ut-robotics/picr22-team-snax/electronics/mainboard_back_side.png

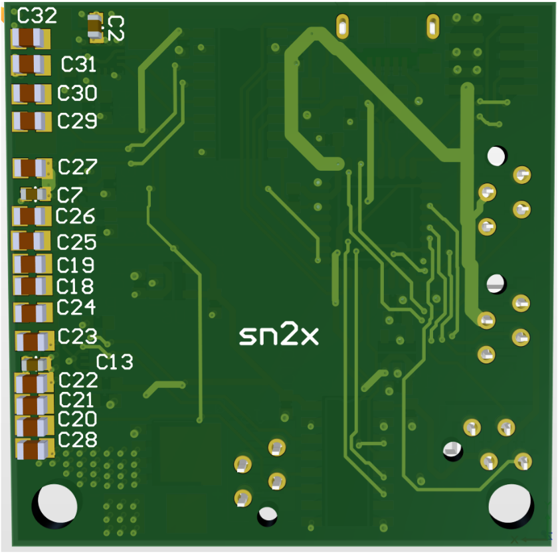
electronics/mainboard_back_side.png
