ut-robotics/picr22-team-snax/electronics/mainboard_front_side.png

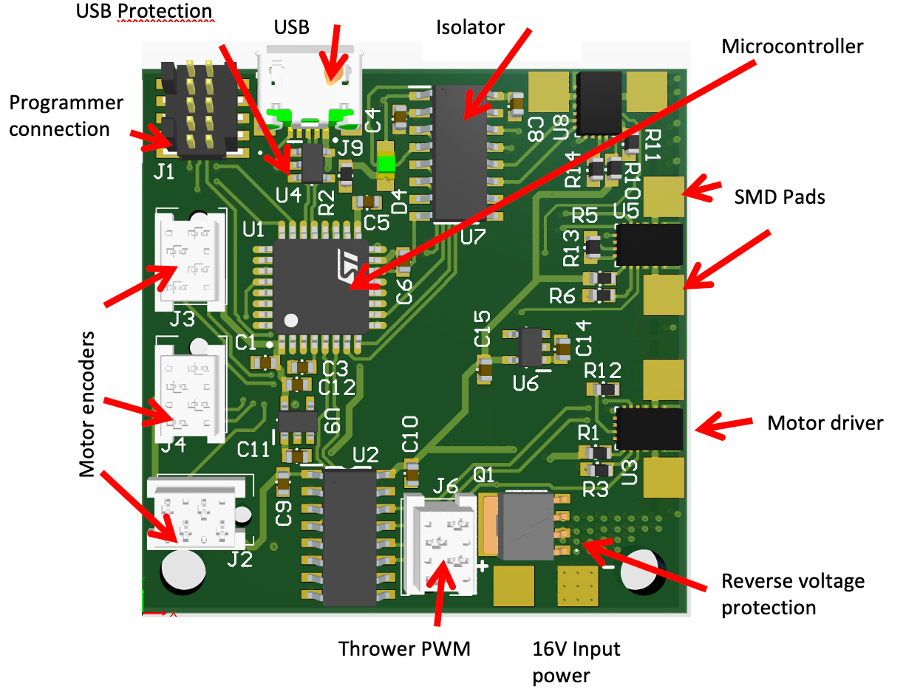
electronics/mainboard_front_side.png
