ut-robotics/picr22-team-snax/electronics/Mainboard schematics.pdf

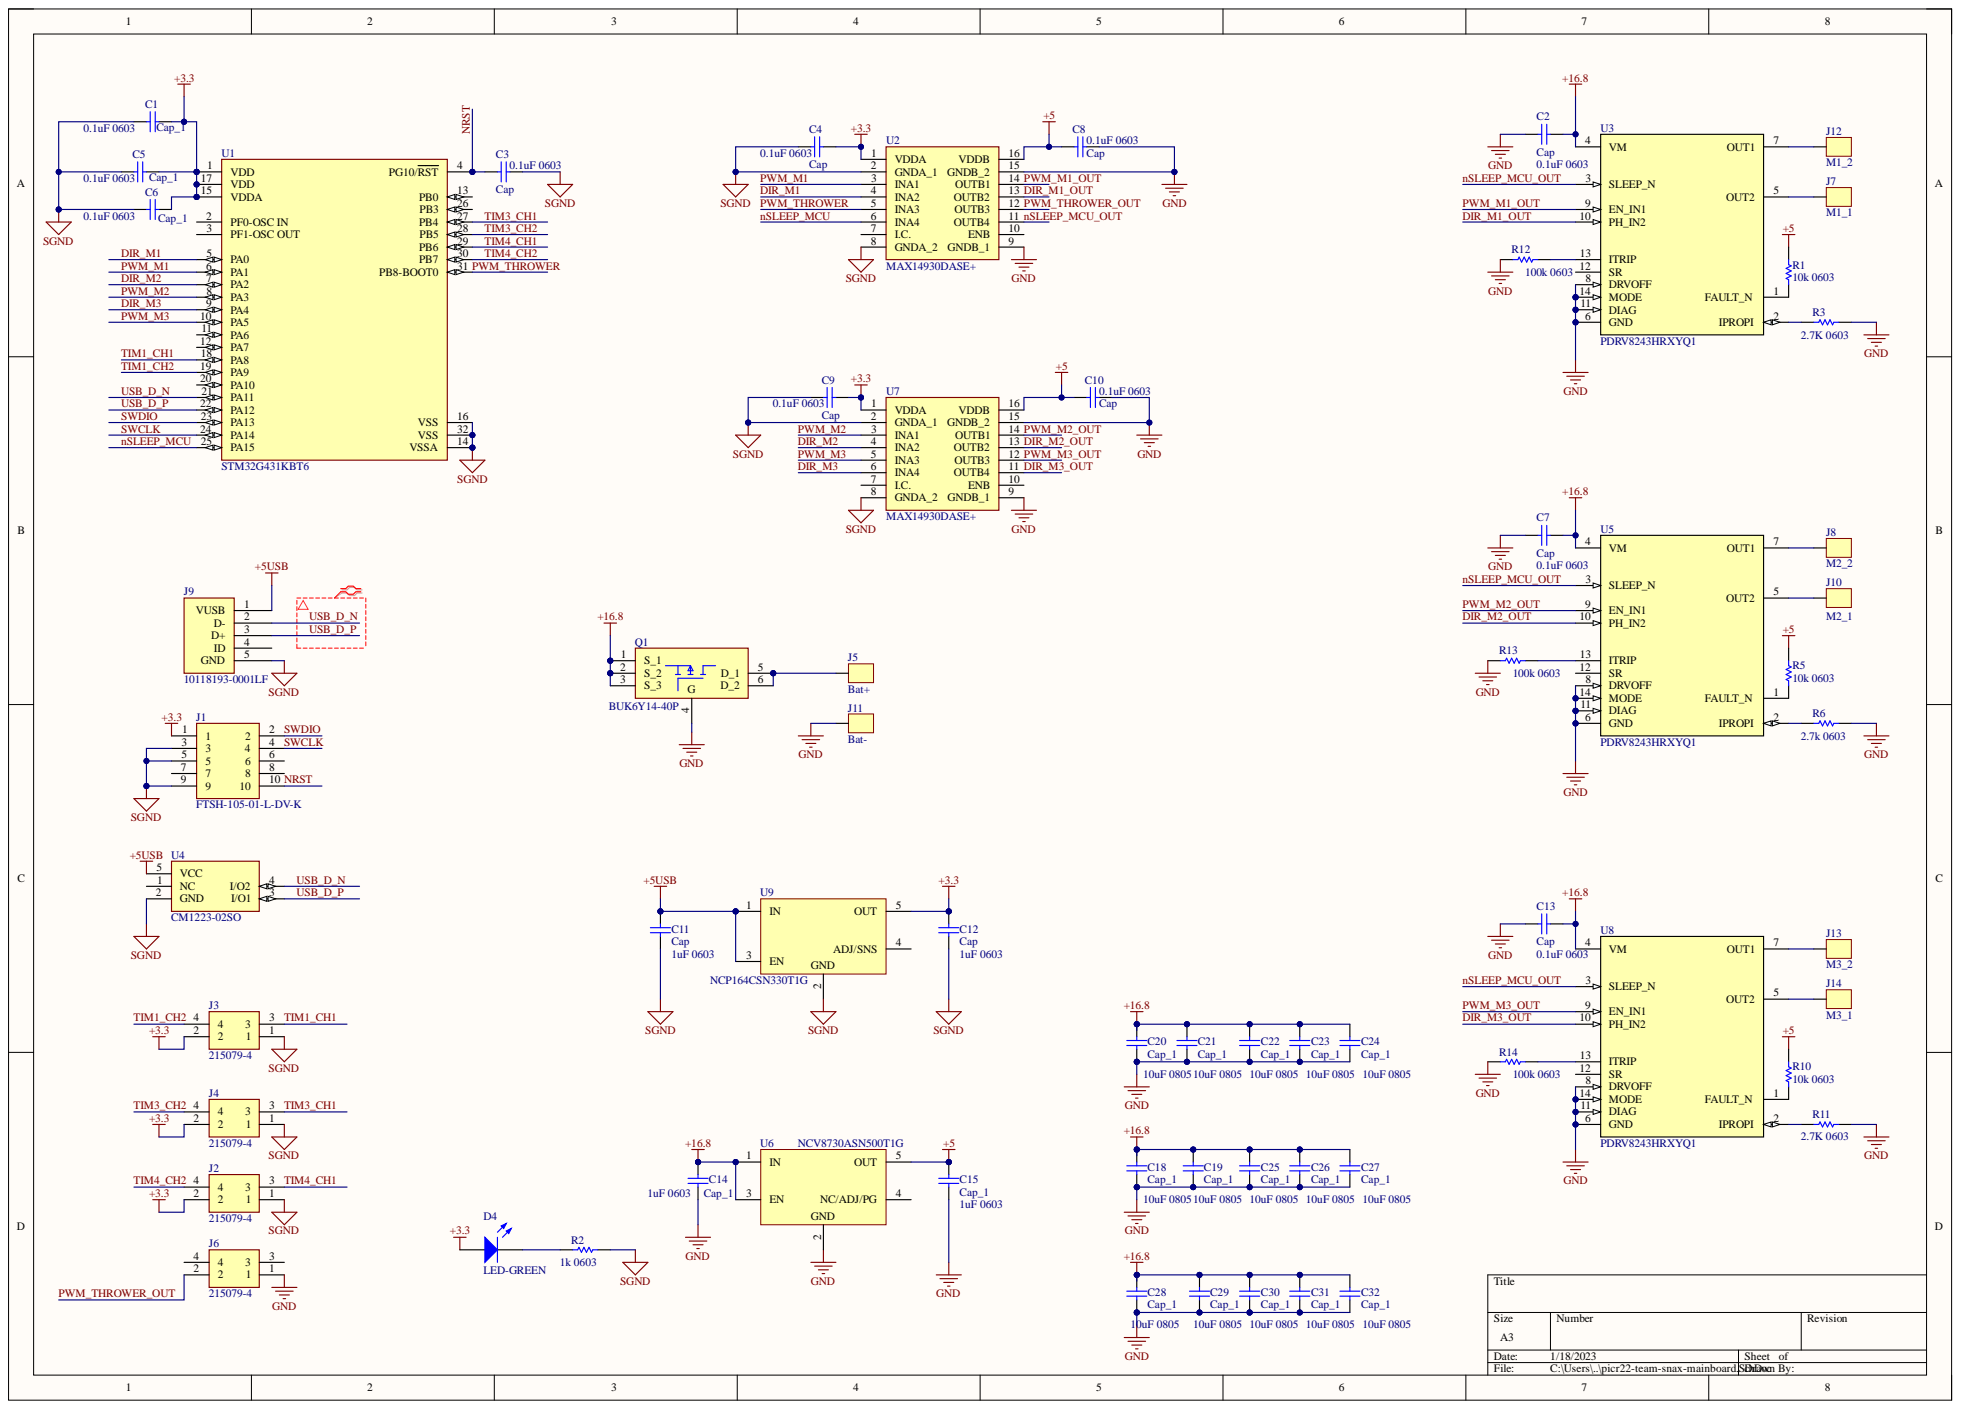
[picture p5: page 1]
