ut-robotics/picr22-team-snax/(list of files, drawings)

Other design files:
electronics/corrcted footprint.PcbLib
electronics/MotorDriver/MotorDriver/MotorDriver.SCHLIB
electronics/NCV8730ASN500T1G.SchLib
electronics/picr22-team-snax-mainboard.PrjPcb
electronics/picr22-team-snax-mainboard.SchDoc
electronics/SOIC-16N.PcbLib
electronics/team-snax-mainboard.PcbDoc
