ut-robotics/picr22-team-snax/(threads)

Thread 1 (2022-10-01):

[Mechanics] dogbones missing

Akustav, 2022-10-01:
You should add dog bones to attach tabs components in a flush manner.

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

Closed 2022-10-09.

Thread 3 (2022-10-01):

[Mechanics] Assembly warnings

Akustav, 2022-10-01:
Currently there are warnings in the assembly file. These should be fixed:
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

Closed 2022-10-27.

Thread 4 (2022-10-01):

[Mechanics] underdefined sketches

Akustav, 2022-10-01:
There are currently under-defined sketches:
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

This can lead to unpredictable changes in model features when another sketch is changed. You should add dimensions until sketches turn black.

ToxaRyd, 2022-10-04:
Did my best but errors of over constrain occur...

Akustav, 2022-10-09:
Hm, currently seems fine to me. Overall when it gives you over-defined warnings, it means that you added multiple different dimensions to the same area. Usually the simplest way to see what is undefined is to take the sketch and try dragging some blue lines around. This shows you what elements start moving.

Closed 2022-10-09.

Thread 5 (2022-10-01):

[Mechanics] Thrower width might be too small

Akustav, 2022-10-01:
Squash balls can be over 40mm in width. Exactly 40 mm might be too tight for balls. This can create issues in getting a ball into the thrower and the ball can rub against the sidewalls when being thrown, reducing throw speeds.

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

Closed 2022-10-09.

Thread 6 (2022-10-01):

[Mechanics] Thrower and ramp are not centered

Akustav, 2022-10-01:
Is this intended, that the thrower and internal ramp don't have the same center point? The further the ball travels in the thrower, the less it is accelerated by the motor.

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

ToxaRyd, 2022-10-04:
Yep, I was suggested that the first contact with the ball should have the motor, and only after the ramps

Akustav, 2022-10-09:
Hm okay... I would suggest to reduce the delta a little, currently it is around 9.5mm:

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

You might remove acceleration potential by reducing contact pressure so fast.

ToxaRyd, 2022-10-14:
Have decreased this distance by 3mm if I am not mistaken....resolved

Closed 2022-10-27.

Thread 7 (2022-10-09):

[Mechanics] Interference in thrower-chassis assembly

Akustav, 2022-10-09:
There is clipping here:

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

Is this intentional or a fault?

ToxaRyd, 2022-10-13:
yeah, thats was because model of that robots and its actual sizes are not the same. I took those from the real one, will try to fix that

ToxaRyd, 2022-10-14:
resolved but there are distance mistakes in the assembly of the robot itself, can show those somehow on practice session

Closed 2022-10-27.

Thread 8 (2022-10-09):

[Mechanics] Thrower motor not attached

Akustav, 2022-10-09:
It is useful to have the motor also attached to the thrower with the cable lead marked. This allows you to see that there is a path for the cables to exit.

ToxaRyd, 2022-10-14:
resolved

Closed 2022-10-27.

Thread 9 (2022-10-09):

[Mechanics] IMPORTANT!!! Edit files in the project instead of uploading

Akustav, 2022-10-09:
Currently you upload f3z files to the project. I think you upload them over the browser as well. This makes it hard to review the project, since I need to download the file and upload it back through fusion 360 to access the models.

You should use the picr22-team-snax project in the PICR team to create and edit files.

ToxaRyd, 2022-10-13:
Resolved!

Closed 2022-10-27.

Thread 10 (2022-11-09):

MCU pin assignment

ReikoR, 2022-11-09:
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

USB and programmer pins must be connected to pins PA11 to PA14:
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

Timer 1, 2 and 3 channels can't be connected to pins PA10 to PA15 like this:
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

Try to use STM32CubeIDE for creating the pin assignment.

Some more information on how to configure timers in STM32CubeIDE is on the firmware page:
https://ut-robotics.github.io/picr22-home/basketball_robot_guide/electronics/firmware.html

Please ask if it's not clear how to do the timer configuration and pin assignment.

ReikoR, 2022-11-22:
New pin assignment should work, but signals connected to `PB4`, `PB5`, `PB6`, `PB7` are incorrectly named.

On schematic:
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

In STM32CubeIDE:
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

Closed 2022-11-29.

Thread 12 (2022-11-09):

Incorrect net labels

ReikoR, 2022-11-09:
1. USB_D_M, USB_D_P
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

3. PWM_THROWER
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

4. PWM_THROWER_OUT
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

5. NRST missing
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

6. PWM_M3_OUT
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

Problems like this can be found with **Project -> Validate PCB Project**:
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

Closed 2022-11-22.

Thread 13 (2022-11-11):

Incorrect USB connenctor pinout

ReikoR, 2022-11-11:
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

Correct pinout:
1. VCC
2. D-
3. D+
4. ID
5. GND

https://pinoutguide.com/PortableDevices/micro_usb_pinout.shtml

Closed 2022-11-22.

Thread 14 (2022-11-11):

Don't use metric grid on the schematic

ReikoR, 2022-11-11:
Industry standard unfortunately is 100 mil grid. All the symbols are designed for it. Using different grid can cause issues with things not aligning with each other.

On the PCB it's better to use metric grid.

ReikoR, 2022-11-22:
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

There are a lot of "Off grid" warnings:
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

Use 100 mil grid and place all schematic object to that grid.

You can set grid to 100 mil (toggle grid with G), select objects on the schematic, use Edit -> Align -> Align To Grid (Shift + Ctrl + D) and adjust manually as necessary.

If symbols were not created with 100 mil grid, then the symbols also need to be changed.

ReikoR, 2022-11-29:
Move schematic objects to 100 mil grid.

One part of the schematic with misalignement:
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

markus-marandi, 2022-12-02:
done

ReikoR, 2022-12-03:
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

markus-marandi, 2022-12-03:
fixed

ReikoR, 2022-12-04:
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

markus-marandi, 2022-12-04:
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

markus-marandi, 2022-12-05:
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

Closed 2022-12-05.

Thread 15 (2022-11-11):

Use different ground nets to isolate MCU and motor drivers sides

ReikoR, 2022-11-11:
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

All MCU side components and all motor drivers side components should be connected to separate grounds. MCU side of the isolators should be connected to MCU ground and motor driver side to motor drivers ground.

Closed 2022-11-22.

Thread 19 (2022-11-11):

Incorrect DRV8243 pinout

ReikoR, 2022-11-11:
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

I guess that the footprint uses multiple pads per actual physical pad. I can't check since the library is not in the repository, but if it is, then it's a bad way to do it, since actual component has less pins:
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

Altium Designer allows the create custom pad shapes:
https://www.altium.com/documentation/altium-designer/working-with-custom-pad-shapes

Closed 2022-11-22.

Thread 20 (2022-11-11):

DRV8243 slew rate configuration

ReikoR, 2022-11-11:
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

Connecting 100k resistor to SR pin sets the slew rate to the highest value:
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

This can't be read form the datasheet, but highest slew rate caused problems last year with motors not starting or rotating properly. Using slew rates of 23 or 28 V/usec worked fine.

Closed 2022-11-22.

Thread 21 (2022-11-11):

DRV8243 current limiting

ReikoR, 2022-11-11:
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

From [datasheet](https://ut-robotics.github.io/picr22-home/basketball_robot_guide/electronics/drv8243-q1_datasheet_2021-08.pdf):
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

A resistor needs to be connected to IPROPI pin to limit the output current.

Current limit should be set to around 2-3A to help prevent motor from overheating. IPROPI resistor value should be calculated based on that.

Closed 2022-11-22.

Thread 24 (2022-11-11):

Bulk capacitors in too small package

ReikoR, 2022-11-11:
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

0603 is too small package for 10uF and especially 220uF 25V+ capacitors.

10uF would be fine in 0805 package.

220uF ceramic capacitor probably does not exist in any reasonable size.

I recommend about 5x 10 uF 0805 capacitors for each motor driver.

Closed 2022-11-30.

Thread 25 (2022-11-13):

[Mechanics] how easy was it to assemble?

Akustav, 2022-11-13:
Overall it seems file but I would have suggested an hourglass shape here for simpler assembly:

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

ToxaRyd, 2022-11-13:
Well, the force needed, though not difficult, may be problems with disassembling but still I a small problem to get rid of extra assembling operation and production of pcb plate to hold the bearings...

Closed 2022-11-13.

Thread 29 (2022-11-22):

3.3V regulator missing

ReikoR, 2022-11-22:
There is no regulator creating the 3.3V from USB 5V.

We have NCP164CSN330T1G regulator in the lab for that.

https://ut-robotics.github.io/picr22-home/basketball_robot_guide/electronics/components.html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

Closed 2022-11-29.

Thread 30 (2022-11-22):

Use switching regulator instead of linear regulator for servo power

ReikoR, 2022-11-22:
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

Linear regulators are too inefficient for higher currents.

We have these components available in the lab:

- XTPS62933DRLR (TPS62933 buck converter)
- SRP6060FA-5R6M (Inductor 5.6uH 10A)

You can use TI WEBENCH to get recommended designs for TI components:
https://webench.ti.com/power-designer/switching-regulator

**Considering that there is not too much time left to complete the design, I would recommend not adding servo connection and continuing with a simpler design.**

markus-marandi, 2022-12-02:
removed servo NCV and 215079-4 components

ReikoR, 2022-12-03:
If you're not using servos, then remove switching regulator and use linear regulator (NCV8730).

Isolators don't need high current and layout of NCV8730 is much simpler.

markus-marandi, 2022-12-03:
added ncv8730

ReikoR, 2022-12-04:
There is no 3.3V regulator any more.
And switching regulator (TPS62933) is still there.

markus-marandi, 2022-12-04:
removed TPS62933 and added ncp164
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

markus-marandi, 2022-12-04:
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

ReikoR, 2022-12-05:
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

Add more input and output capacitance to NCP164.

From [NCP164 datasheet](https://www.onsemi.com/pdf/datasheet/ncp164-d.pdf):
> **Input Decoupling (C<sub>IN</sub>)**
> It is recommended to connect at least 1 uF ceramic X5R or X7R capacitor between IN and GND pin of the device.

> **Output Decoupling (C<sub>OUT</sub>)**
> The device is designed to be stable with standard ceramics capacitors with values of 1 uF or greater.

Closed 2022-12-05.

Thread 31 (2022-11-26):

Add a spacer to the front of the thrower

Akustav, 2022-11-26:
I suggest adding a 45 mm spacer to the front. This increases thrower rigidity but also protects the motor from crashes. Maybe the motor cable angel could also be changed a little so it does not point directly outwards

ToxaRyd, 2022-11-26:
Done)

Akustav, 2022-11-27:
With the current implementation I also suggest rotating the motor so the cable is not routed from the front of the robot. This can damage the cables when hitting something.

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

ToxaRyd, 2022-11-29:
done

Closed 2022-11-30.

Thread 33 (2022-11-26):

No holes for camera mount fixating

Akustav, 2022-11-26:
The bottom plate has no holes for the camera mount, currently.

ToxaRyd, 2022-11-27:
done

Akustav, 2022-11-27:
The side wall holes are drilled manually but would be good if they are also added.

ToxaRyd, 2022-11-29:
easy to do but afraid of problems when making machining model...

Closed 2022-11-30.

Thread 34 (2022-11-26):

More support for camera legs

Akustav, 2022-11-26:
I suggest a little more support for the camera legs since they can wobble about, when the robot is is motion. The slots do not help. Maybe add a plate to the middle of the legs?

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

ToxaRyd, 2022-11-26:
Yeah, I planned to add there a plane, I just have not finished yet)

Akustav, 2022-11-27:
I see something added. How do you plan to fasten it. Additionally how do you plan to manufacture it?

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

ToxaRyd, 2022-11-27:
3d printing, cause it is just rigid component, no fixing needed, maybe just position fix through the adjustment of the holes in the camera legs

Akustav, 2022-11-27:
Some force needs to hold it in place, no? If it is just rattling there, there is little rigidity and support it is adding. If it were somewhat wider and was squeezed between the two legs, then maybe it can be a friction fit.

ToxaRyd, 2022-11-28:
please check the newer version

Closed 2022-11-30.

Thread 36 (2022-11-26):

Underdefined sketch

Akustav, 2022-11-26:
The sketch is underdefined for the camera legs.

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

Also... This camera leg reminds me an awful lot of the mount used by this robot. whats up with that:

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

ToxaRyd, 2022-11-27:
defining sketches fully is a highly time consuming habit especially when smth needs to be redone, also I have never experienced any problems with that throughout 6 years of CAD exp...

ToxaRyd, 2022-11-27:
Speaking of those mount slots, I may redo the entire leg to be thinner at those places by reducing the mount slots...

Akustav, 2022-11-27:
Fully defining sketches is a good practice. Currently this sketch looks like a carbon copy-paste from the previous years robot that borders on plagiarism with its distinct features.

A side-to-side here:

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

ToxaRyd, 2022-11-28:
Indeed the initial sketch was copy pasted from the test model given to my team, further - modified much. The reason - is simply saving time in terms of defining all the dimensions and of course, saving all angles to eliminate any extra job to be done for my team, if to speak about those mounting holes - I did find them very useful when additional electronics need to be fixed somewhere...

Closed 2022-11-30.

Thread 37 (2022-11-27):

Cameras RGB sensor is not centered on the robot

Akustav, 2022-11-27:
The RGB sensor is not centered:

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

Additionally there is no FOV cone to check if the cameras location is good.

ToxaRyd, 2022-11-27:
about FOV con - I have leaved all parameters (height at least and camera plate holder angle) the same as in the old one, I was thinking to eliminate any possibilities for my team to redo calibration in their SW and waste time on it, so the camera location is good, except is that RGB camera is not centered yet...

Akustav, 2022-11-27:
Would be good to see that the current thrower to camera location is good or did that also not change?

ToxaRyd, 2022-11-28:
hard to remember, but any minor changes won't change much in that respect

ToxaRyd, 2022-11-29:
donedonedone

Closed 2022-11-30.

Thread 38 (2022-11-27):

Electronics board, switches and plugs missing

Akustav, 2022-11-27:
I can not find any PC power plugs, switches or similar on the robot. Also if you want to use moutnable XT-60 sockets like these, we have them in the lab.

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

ToxaRyd, 2022-11-28:
All electronics is located near to the rear wheel, all the connections are gonna be made as in the test robot - in air

Closed 2022-11-30.

Thread 40 (2022-11-27):

Routing of USB cables

Akustav, 2022-11-27:
I hope there is enough space for the USB cables so they don't get destroyed by the wheels:

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

ToxaRyd, 2022-11-28:
Yep, There is enough space + holes in the legs so everything is gonna be fine)

Closed 2022-11-30.

Thread 42 (2022-11-28):

Dogbones and holes in upper plate

maidlam, 2022-11-28:
1. Dogbones missing
2. What's the function of these holes?

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

ToxaRyd, 2022-11-28:
2 - for the thrower motor cable

Closed 2022-11-29.

Thread 43 (2022-11-28):

Camera mount holder plate bolt holes not functional and dogbones not millable

maidlam, 2022-11-28:
Bottom holes of the holder plate wont go fully into the plate. Top holes will go partly into the curved corners, which can cause issues during manufacturing.

The dogbones of the holder plate are 1 mm in diameter. I think we don't have that small of an endmill in the lab.
3 mm dogbones should not interfere with functinality.

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

Closed 2022-11-29.

Thread 44 (2022-11-28):

Motor mount dogbones not millable

maidlam, 2022-11-28:
The dogbones of the motor mounts' tenons are not millable because a 3 mm mill wont be able to pass through the gap of the dogbones.
Making the dogbones like the red line can also give more support to the sides of the tenons of the motor mount.

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

ToxaRyd, 2022-11-28:
fixed

Closed 2022-11-29.

Thread 45 (2022-11-29):

Camera holder wall dogbones not millable

maidlam, 2022-11-29:
The dogbones on the bottom of the camera holder wall are not millable due to both the current position of the dogbones and the hole size.

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

ToxaRyd, 2022-11-29:
done?!

Akustav, 2022-11-30:
One note here is that they can technically also be drilled but it takes a little more time with such a small drill and with the tool changes required

ToxaRyd, 2022-12-01:
Done

Closed 2022-12-01.

Thread 46 (2022-11-29):

Interference between top plate and camera holder wall

maidlam, 2022-11-29:
There is interference between the top plate and the camera holder walls.

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

ToxaRyd, 2022-12-01:
Fixed, I guess

Closed 2022-12-01.

Thread 48 (2022-11-29):

Reverse voltage protection MOSFET connected incorrectly

ReikoR, 2022-11-29:
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

Gate needs to be connected to GND.

markus-marandi, 2022-12-02:
done

ReikoR, 2022-12-03:
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

* Gate (G) needs to be connected to GND.
* Source (S) needs to be connected to +16.8.
* Bat- needs to be connected to GND.

Don't add additional labels to wires connected to power port. Power port already assigns a net name.
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

markus-marandi, 2022-12-03:
corrected connections

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

Closed 2022-12-04.

Thread 50 (2022-11-29):

NCV8730 input connected incorrectly

ReikoR, 2022-11-29:
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

+16.8 needs to be connected to IN pin.
Input capacitor needs to be between +16.8 and GND.

markus-marandi, 2022-12-02:
removed this component

ReikoR, 2022-12-03:
Use NSV8730 instead of switching regulator.

See https://github.com/ut-robotics/picr22-team-snax/issues/30#issuecomment-1336138949

markus-marandi, 2022-12-04:
added ncv8730 back

Closed 2022-12-04.

Thread 51 (2022-11-29):

DRV8243 DRVOFF incorrectly connected

ReikoR, 2022-11-29:
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

DRVOFF pin should not be connected to ITRIP pin.

markus-marandi, 2022-12-02:
done

ReikoR, 2022-12-03:
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

100k resistor needs to be connected to ITRIP pin to configure threshold voltage for current limiting.

ReikoR, 2022-12-04:
DRVOFF pin can be connected straight to GND without any resistors.
`DRV_OFF_OUT` net label can be removed. Currently all DRVOFF pins would be connected together.

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

markus-marandi, 2022-12-04:
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

Closed 2022-12-05.

Thread 52 (2022-11-29):

Use 0603 resistors

ReikoR, 2022-11-29:
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

Resistors available in the lab are in 0603 package.

markus-marandi, 2022-12-02:
done

ReikoR, 2022-12-03:
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

markus-marandi, 2022-12-03:
fixed

Closed 2022-12-04.

Thread 53 (2022-11-29):

Use 4 layers instead of 2

ReikoR, 2022-11-29:
4 layer PCB with both inner layers being grounds is much better for signal integrity.

If there are gaps in ground (or any other reference layer), then return currents have to go around the gaps and electromagnetic fields will spread out more causing more crosstalk.

Also, if distance between signal and reference plane is bigger then fields will spread out more and cause more crosstalk.
In 4-layer PCB, distances between layers 1-2 and 3-4 are usually small (0.2mm or less).

More detailed design advice:
https://www.protoexpress.com/blog/best-high-speed-pcb-routing-practices/

Also, from JLCPCB both 2-layer and 4-layer PCBs up to 50x50mm size cost the same.

Recommended layer usage:
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

markus-marandi, 2022-12-02:
done

ReikoR, 2022-12-03:
Add ground polygons to inner layers.

Closed 2022-12-05.

Thread 54 (2022-11-29):

Incorrect MAX14930DASE+ footprint

ReikoR, 2022-11-29:
MAX14930DASE+ is in narrow package, not wide.

From [datasheet](https://datasheets.maximintegrated.com/en/ds/MAX14130-MAX14932.pdf):
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

From Altium Designer component properties:
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

markus-marandi, 2022-12-02:
done

Closed 2022-12-03.

Thread 55 (2022-11-30):

Improve component placement

ReikoR, 2022-11-30:
1. Divide PCB into two parts:
    * microcontroller and everything connected to it;
    * motor drivers and related components.
\
Something like this:
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

3. Place components that connect to each other close to each other.
\
ESD protection needs to be as close as possible to USB connector, otherwise ESD spikes will reach other components before ESD protection.
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
\
It's better to place USB connector close to microcontroller, instead of routing long tracks across the PCB.
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
\
Decoupling capacitors should be placed as close as possible to power supply pins of a component. Shorter connections have less inductance.
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

ReikoR, 2022-12-03:
1. Isolator rotated incorrectly. Microcontroller side signals are on the other side.
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

2. Thrower connector needs to be on the motor drivers side.
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

3. Place decoupling capacitors close to supply pins on the same layer as the component.
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

markus-marandi, 2022-12-04:
1. rotated isolator
2. moved thrower connector
3. replaced decoupling capacitors
4. replaced esd protection
5. moved and rotated programmer connector

Closed 2022-12-06.

Thread 57 (2022-11-30):

Use wider tracks, polygons and multiple vias for higher currents

ReikoR, 2022-11-30:
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

0.127 mm wide track can carry about 1 A of current at 20 degrees temperature rise:
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

Each motor driver is limited to about 3 A in the current design.

I don't think it's possible to carry 9 A of current with 0.127 mm wide track.

Motor driver inputs and outputs need to able to carry 3 A of current.
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

ReikoR, 2022-12-06:
Polygon not connected to battery input pad:
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

markus-marandi, 2022-12-06:
done

Thread 58 (2022-11-30):

Make PCB smaller

ReikoR, 2022-11-30:
Try to make the PCB 50 x 50 mm or smaller as it's the cheapest option from JLCPCB.

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

markus-marandi, 2022-12-02:
done

ReikoR, 2022-12-03:
PCB can be made smaller.

markus-marandi, 2022-12-05:
new dimensions are 40x40

Closed 2022-12-05.

Thread 59 (2022-11-30):

Switches and power plugs covered by PC

Akustav, 2022-11-30:
The computers chassis covers the switches and sockets:

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

Also refer to this page for desired hole sizes:

https://ut-robotics.github.io/picr22-home/basketball_robot_guide/mechanics/design.html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

ToxaRyd, 2022-12-01:
Yep, those are bad, I decided to make them 3d printed and attached to the bottom plate!

Akustav, 2022-12-01:
The current switches can be triggered by an opponent or ball. If you dont have room I suggest putting them here:
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

ToxaRyd, 2022-12-01:
Those switches are too big, putting them there will jeopardize the camera holder leg seriously (at least it does not seem reliable, and I don't like those things) But I will think on where else to put those

ToxaRyd, 2022-12-02:
Actually, I am a lazy ass, so I decided to make as you said, but the charging port remains on the holder 3d printed plate. Please check if it is ok...

maidlam, 2022-12-04:
Make the cutouts for the switch holes like this (from the guide).
If the hole is too thick, then the clips on the sides of the switches wont engage and the switch can come out.

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

ToxaRyd, 2022-12-04:
> Make the cutouts for the switch holes like this (from the guide). If the hole is too thick, then the clips on the sides of the switches wont engage and the switch can come out.
>
> 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

the hole is 4.8mm, but the part is one. meaning that on both parts manufactured the whole gonna be from on side only. So this thing will be done manualy

maidlam, 2022-12-04:
Why make them by hand?
They only need a pocket and contour operation from one side, which the CNC can cut out quickly.

ToxaRyd, 2022-12-04:
> Why make them by hand? They only need a pocket and contour operation from one side, which the CNC can cut out quickly.

The part gonna be then asymmetrical, I will need to do two walls' models. And I cannot do this cut from both sides...

maidlam, 2022-12-05:
> I don't think there gonna be any problems with reaching the other side of the plate...
The switch can reach the other side, but it wont be in place correctly, because the clips wont engage.

> I will need to do two walls' models
You can make one of them and then create a mirror body with the mirror feature.

ToxaRyd, 2022-12-05:
done

Closed 2022-12-08.

Thread 60 (2022-11-30):

Suggest making cable routing hole bigger

Akustav, 2022-11-30:
I suggest making the hole for cable routing bigger since every bullet of D=3.5mm needs to fit in there while other cables are already in there. Also consider the internal corner radius when milling.

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

ToxaRyd, 2022-12-01:
Done

Closed 2022-12-01.

Thread 61 (2022-12-03):

Remove 3rd isolator

ReikoR, 2022-12-03:
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

* SERVO PWM signal is not used.
* Motor driver DRVOFF pin can be connected to GND to have drivers enabled. It's probably not needed for the microcontroller to turn off the motor drivers.

markus-marandi, 2022-12-03:
removed 3rd isolator

Closed 2022-12-04.

Thread 62 (2022-12-03):

Motor driver capacitor footprint incorrect

ReikoR, 2022-12-03:
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

It seems to be for 1608 (1.6x0.8mm) metric package (0603 imperial), not 0805 imperial package (2012 metric).

markus-marandi, 2022-12-04:
where can I validate if the footprints are updated with this measuring tool? Updated all the motor driver capacitor footprints.

Closed 2022-12-04.

Thread 63 (2022-12-03):

Route USB data signals as differential pair

ReikoR, 2022-12-03:
More information here:
https://github.com/ut-robotics/picr22-team-gibibot/issues/32

## But use JLC7628 stackup as it is cheaper.

For example 8 mil (about 0.2 mm) trace space and 10.28 mil (about 0.26 mm) trace width would work:
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

markus-marandi, 2022-12-04:
routed usb as differential pair

markus-marandi, 2022-12-04:
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

markus-marandi, 2022-12-04:
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

ReikoR, 2022-12-06:
Straighten the tracks:
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

markus-marandi, 2022-12-06:
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

Closed 2022-12-06.

Thread 64 (2022-12-03):

Gap between BUK6Y10-30P drain pads

ReikoR, 2022-12-03:
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

Try to get rid of the gap or just use one pad for drain.

markus-marandi, 2022-12-04:
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

PCB editor still shows a cap, when its corrected from library and updated

ReikoR, 2022-12-04:
Which library are you using?

 It's not in the repository.

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

markus-marandi, 2022-12-05:
added library to repository

Closed 2022-12-05.

Thread 67 (2022-12-04):

CAM operations issues

maidlam, 2022-12-04:
Drill:

- In the Heights tab, check over the From and Offset of the operation heights
https://ut-robotics.github.io/picr22-home/basketball_robot_guide/mechanics/cam.html#_drilling

Pocket:

- Add -0,05 mm of Radial Stock to Leave, set axial to 0.
https://ut-robotics.github.io/picr22-home/basketball_robot_guide/mechanics/cam.html#_pocket

2D Contour (inner)

- Enable tabs, change the Positioning Method to "Segment", adjust the tab distance so it generates two tabs inside the motor mount holes.
This is done so that the material left in the hole doesn't fly out after cutting.
- Add -0,05 mm of Radial Stock to Leave, set axial to 0.
- Under the Linking tab, disable "Keep Tool Down", it's causing some unwanted cuts when moving between contours.

ToxaRyd, 2022-12-04:
got it!

ToxaRyd, 2022-12-05:
Almost everything was fixed, though the outer contour swears on leads, dunno how to solve that

ToxaRyd, 2022-12-05:
Actually I did fix the lead problem by specifying the "Add -0,05 mm of Radial Stock to Leave, set axial to 0" in outer contour

ToxaRyd, 2022-12-05:
So I was contacted by my teram member to make some changes into pcb fitting, and after that I got a warning of working offset
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

ToxaRyd, 2022-12-05:
everything was donedonedone

Closed 2022-12-08.

Thread 68 (2022-12-06):

Vias too small

ReikoR, 2022-12-06:
Minimum vias size should be 0.2 mm hole / 0.45 mm diameter.

From https://jlcpcb.com/capabilities/pcb-capabilities:
> For Multi Layer PCB, the minimum via hole size is 0.2mm
> For Multi Layer PCB, the minimum via diameter is 0.45mm

Some vias have diameter of 0.4 mm:
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

markus-marandi, 2022-12-06:
done

Closed 2022-12-06.

Thread 70 (2022-12-06):

Avoid placing reference designators underneath components

ReikoR, 2022-12-06:
Reference designators should be visible when components have been soldered on the PCB.

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

markus-marandi, 2022-12-06:
done

Closed 2022-12-06.
