ut-robotics/picr22-team-snax/firmware/snax/snax_firmware.ioc

Mcu.UserName=STM32G441KBTx
PA0.GPIO_Label=M1_DIR
PA12.Signal=USB_DP
PB6.Signal=S_TIM4_CH1
PB7.Signal=S_TIM4_CH2
PA8.Signal=S_TIM1_CH1
PA0.Signal=GPIO_Output
PA2.GPIO_Label=M2_DIR
PA15.Signal=S_TIM8_CH1
PB8-BOOT0.GPIO_Label=THROWER
PA4.GPIO_Label=M3_DIR
PB4.Signal=S_TIM3_CH1
PA3.Signal=S_TIM2_CH4
PA13.Signal=SYS_JTMS-SWDIO
PA9.Signal=S_TIM1_CH2
PA1.Signal=S_TIM2_CH2
PA5.Signal=S_TIM2_CH1
PB8-BOOT0.Signal=S_TIM16_CH1
PA1.GPIO_Label=M1_PWM
PA2.Signal=GPIO_Output
PA4.Signal=GPIO_Output
PB5.Signal=S_TIM3_CH2
PA5.GPIO_Label=M3_PWM
PA11.Signal=USB_DM
PA14.Signal=SYS_JTCK-SWCLK
PA3.GPIO_Label=M2_PWM
