ut-robotics/picr22-team-snax/(commit log)

2022-09-19 initial electronics commit
    [picr22-team-snax-mainboard.PrjPcb, picr22-team-snax-mainboard.SchDoc]
2022-11-03 added driver inputs
    [picr22-team-snax-mainboard.SchDoc]
2022-11-06 updated schematics
    [picr22-team-snax-mainboard.SchDoc]
2022-11-21 fixed issues, added servo control
    [picr22-team-snax-mainboard.PrjPcb, picr22-team-snax-mainboard.SchDoc]
2022-11-21 changed placement of schematics
    [picr22-team-snax-mainboard.SchDoc]
2022-11-22 started with pcb design
    [picr22-team-snax-mainboard.PcbDoc, picr22-team-snax-mainboard.PrjPcb, picr22-team-snax-mainboard.SchDoc]
2022-11-22 added LED footprints
    [picr22-team-snax-mainboard.PcbDoc, picr22-team-snax-mainboard.SchDoc]
2022-11-22 fixed new issues, waiting for cad license renewal
    [picr22-team-snax-mainboard.PcbDoc, picr22-team-snax-mainboard.SchDoc]
2022-11-23 fixed issues
    [picr22-team-snax-mainboard.PcbDoc, picr22-team-snax-mainboard.PrjPcb, picr22-team-snax-mainboard.SchDoc]
2022-11-24 plaed components on pcb
    [picr22-team-snax-mainboard.PrjPcb, picr22-team-snax-mainboard.SchDoc, team-snax-mainboard.PcbDoc]
2022-11-28 pcb design
    [team-snax-mainboard.PcbDoc]
2022-11-28 fixed design errors
    [team-snax-mainboard.PcbDoc]
2022-11-28 v1 finalised pcb design
    [components file.xlsx, picr22-team-snax-mainboard.PrjPcb, team-snax-mainboard.PcbDoc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]
2022-11-30 removed servo support
    [Copy of team-snax-mainboard.PcbDoc, NCV8730ASN500T1G.SchLib, picr22-team-snax-mainboard.PrjPcb, picr22-team-snax-mainboard.SchDoc, team-snax-mainboard.PcbDoc]
2022-11-30 removed servo support
    removed two components (NCV and 215079-4) for servo support
    [picr22-team-snax-mainboard.SchDoc, team-snax-mainboard.PcbDoc]
2022-12-01 updated MAX footprint
    [SOIC-16N.PcbLib, picr22-team-snax-mainboard.PrjPcb, picr22-team-snax-mainboard.SchDoc, team-snax-mainboard.PcbDoc]
2022-12-01 finalized pcb before routing
    [SOIC-16N.PcbLib, picr22-team-snax-mainboard.SchDoc, team-snax-mainboard.PcbDoc]
2022-12-01 started routing pcb, palced components
    [team-snax-mainboard.PcbDoc]
2022-12-02 changed resistors to 0603 package
    [picr22-team-snax-mainboard.SchDoc]
2022-12-02 changed resistors on pcb
    [team-snax-mainboard.PcbDoc]
2022-12-03 fixed schematic issues
    [picr22-team-snax-mainboard.SchDoc, team-snax-mainboard.PcbDoc]
2022-12-04 schematic corrected
    [picr22-team-snax-mainboard.SchDoc, team-snax-mainboard.PcbDoc]
2022-12-04 fixed schematic
    [corrcted footprint.PcbLib, picr22-team-snax-mainboard.PrjPcb, picr22-team-snax-mainboard.SchDoc, team-snax-mainboard.PcbDoc]
2022-12-04 fixed capacitor footprints
    [picr22-team-snax-mainboard.SchDoc, team-snax-mainboard.PcbDoc]
2022-12-04 corrected components placement on pcb
    [picr22-team-snax-mainboard.SchDoc, team-snax-mainboard.PcbDoc]
2022-12-04 placed components for routing
    [team-snax-mainboard.PcbDoc]
2022-12-04 half of the board completed
    [team-snax-mainboard.PcbDoc]
2022-12-04 added gitignore and cleaned up
    [Copy of team-snax-mainboard.PcbDoc, picr22-team-snax-mainboard.SchDoc]
2022-12-04 poured polygons
    [picr22-team-snax-mainboard.SchDoc, team-snax-mainboard.PcbDoc]
2022-12-04 finished pcb design and poured polygons
    [team-snax-mainboard.PcbDoc]
2022-12-05 added team name
    [team-snax-mainboard.PcbDoc]
2022-12-05 fixed some connections and updated polygons
    [team-snax-mainboard.PcbDoc]
2022-12-05 updated schematic
    [picr22-team-snax-mainboard.PrjPcb, picr22-team-snax-mainboard.SchDoc, team-snax-mainboard.PcbDoc]
2022-12-05 changed ncp164 capacitors
    [picr22-team-snax-mainboard.SchDoc]
2022-12-05 fixed polygons
    [team-snax-mainboard.PcbDoc]
2022-12-05 fixed rule check errors
    [team-snax-mainboard.PcbDoc]
2022-12-05 updated ncv footprint
    [MotorDriver.SCHLIB, picr22-team-snax-mainboard.PrjPcb, picr22-team-snax-mainboard.SchDoc, team-snax-mainboard.PcbDoc]
2022-12-05 added gerber files
    [components file.xlsx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]
2022-12-05 final designs
    [picr22-team-snax-mainboard.PrjPcb, team-snax-mainboard.PcbDoc]
2022-12-06 fixed issues and updated gerber files
    [team-snax-mainboard.PcbDoc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]
2022-12-06 refernce designators fixed, gerbers generated
    [picr22-team-snax-mainboard.PrjPcb, team-snax-mainboard.PcbDoc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]
2022-12-06 routing fixes, generated new gerbers
    [team-snax-mainboard.PcbDoc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]
2022-12-06 fixed one designator, generated new gerbers
    [team-snax-mainboard.PcbDoc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]
2023-01-10 minor updates to pcb
    [team-snax-mainboard.PcbDoc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]
2023-01-13 changed main logic, fixed issues in usb_files
    [snax_firmware.ioc]
2023-01-13 updated firmware because of build errors
    [snax_firmware.ioc]
2023-01-21 added sn2x_components.tsv
    [sn2x_components.tsv]
2023-01-22 added schematics
2023-01-22 updated BOM
    [sn2x_components.tsv]
2023-01-22 resolving PR requests
    [MotorDriver.SCHLIB, NCV8730ASN500T1G.SchLib, SOIC-16N.PcbLib, corrcted footprint.PcbLib, picr22-team-snax-mainboard.PrjPcb, picr22-team-snax-mainboard.SchDoc, sn2x_components.tsv, team-snax-mainboard.PcbDoc]
